belisarius530/ubalance/readme.txt

This is the first of many files,
may they all be merry and bright -JF
