belisarius530/ubalance/chassis/gsegNucleoPlatev0.pdf

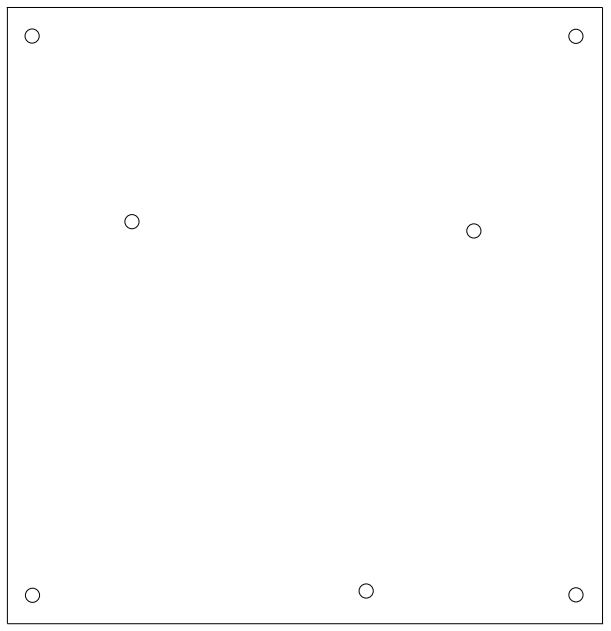
[picture p1: figure]
