belisarius530/ubalance/chassis/gsegNucleoPlatev1.pdf

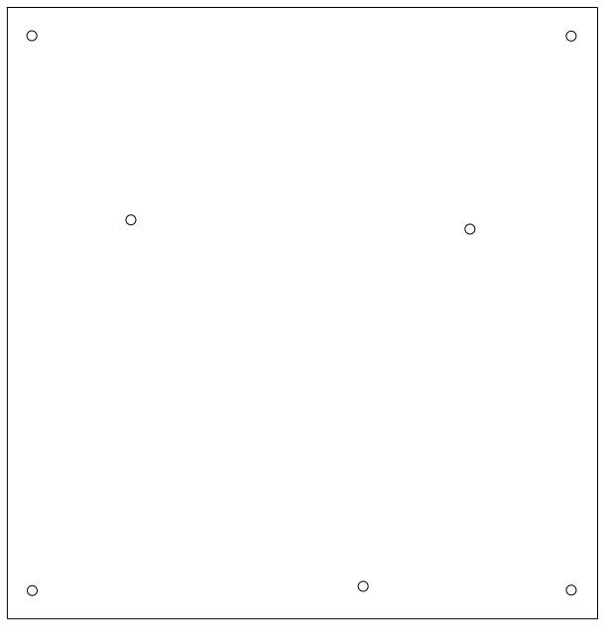
[picture p2: figure]
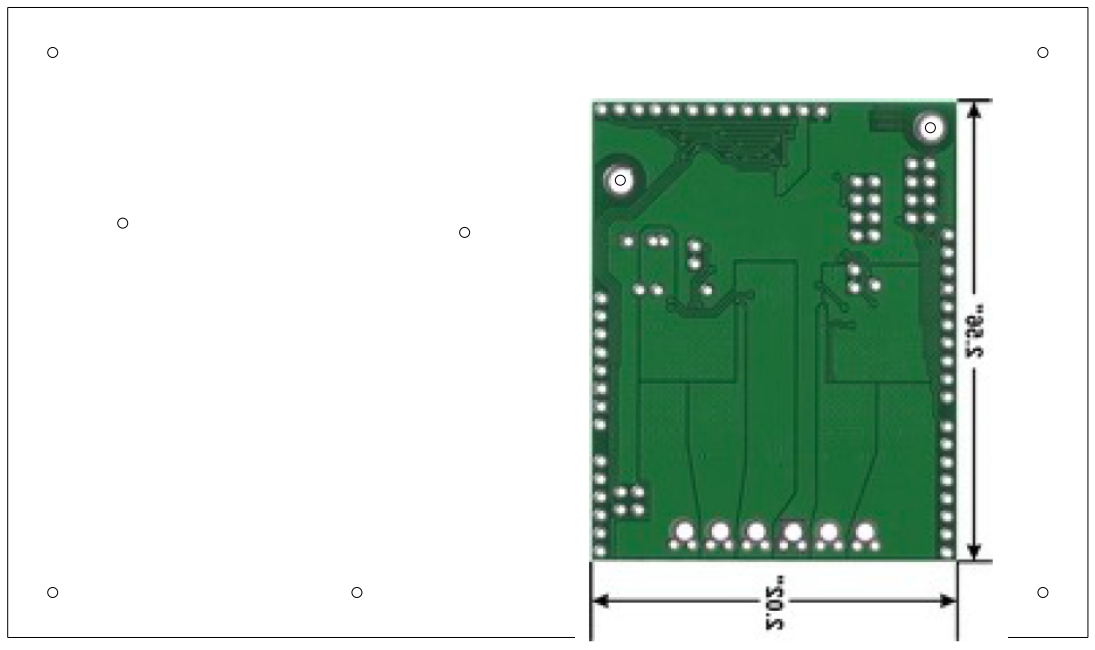
[picture p3: figure]
