belisarius530/ubalance/bom/ubalancev0.xlsx

BOM
EE521, IRL Avatar
Power Supply
Part Name | Mfc. Part Number | Specs | Footprint | Notes | Datasheet Link | Cost | Order Link | Added to digikey order
BUCK | LT3470 | 200mA, 83% efficient for 12-to-5V from 75mA up to 200mA | TSOT-23-8 | 1/b | LT3470 (http://cds.linear.com/docs/en/datasheet/3470fd.pdf) | 5.4 | Digikey (http://www.digikey.com/product-detail/en/LT3470ETS8%23TRMPBF/LT3470ETS8%23TRMPBFCT-ND/1629843) | 2
C1A, C2C, C3B | 250X15W104MV4E | .1uF, 20%, X7R , 25, Bypass/Decouple DIFFERENT FROM OTHER .1!!!! Use ON power supply and motors | 805 | 3/b | Cap (http://www.johansondielectrics.com/images/stories/surface-mount/x2y/JDI_X2Y_2013-04.pdf) | 0.55 | Digikey (http://www.digikey.com/product-detail/en/250X15W104MV4E/709-1330-1-ND/2327230) | 6
C1B, C2D | C2012X7R1E105K125AB | 1uF, 10%, 25V, MLCC, X7R | 805 | 2/b | C-series TDK Caps (http://www.tdk.com/pdf/TDKMLCCCapRange.pdf) | 0.24 | Digikey (http://www.digikey.com/product-detail/en/C2012X7R1E105K125AB/445-1354-1-ND/567595) | 4
C1C, C2B | EEE-FK1V101XP | 100uF, Aluminum, 340mOhm at 100KHz, Rated Ripple Current - 280mA | FK Series D, D8 Surface Mount Cap | 2/b | Panasonic Caps (http://industrial.panasonic.com/ww/products/capacitors/aluminum-capacitors/aluminum-cap-smd/fk-v/EEEFK1V101XP) | 0.76 | Digikey (http://www.digikey.com/product-detail/en/EEE-FK1V101XP/PCE3836CT-ND/766212) | 4
CBIASFB | C0805C220KBRACTU | 22pF, X7R, 10%, 630V(!) | 805 | 1/b | C0805C220KBRACTU Spec. (http://capacitoredge.kemet.com/capedge2/DataSheet?pn=C0805C220KBRACTU) | 0.37 | Digikey (http://www.digikey.com/product-detail/en/C0805C220KBRACTU/399-5568-1-ND/2033930) | 2
R2 | KTR10EZPF2003 | 200k, 1% | 805 | 1/b | KTR Series (http://rohmfs.rohm.com/en/products/databook/datasheet/passive/resistor/chip_resistor/ktr.pdf) | 0.17 | Digikey (http://www.digikey.com/product-detail/en/KTR10EZPF2003/RHM200KAHCT-ND/1983967) | 4
R1 | ERJ-6ENF6043V | 600k, 1% | 805 | 1/b | ERJ (http://industrial.panasonic.com/www-cgi/jvcr13pz.cgi?E+PZ+3+AOA0002+ERJ6ENF6043V+7+WW) | 0.1 | Digikey (http://www.digikey.com/product-detail/en/ERJ-6ENF6043V/P604KCCT-ND/119776) | 4
R3 | RMCF1206JT1M00 | 1M, 5% | 805 | 1/b | ERJ (http://industrial.panasonic.com/www-cgi/jvcr13pz.cgi?E+PZ+3+AOA0002+ERJ6ENF1004V+7+WW) | 0.1 | Digikey (http://www.digikey.com/product-detail/en/ERJ-6ENF1004V/P1.00MCCT-ND/119836) | 4
R4, R5 | ERJ-6GEYJ104V | 100k, 1% | 805 | 2/b | ERJ (http://industrial.panasonic.com/www-cgi/jvcr13pz.cgi?E+PZ+3+AOA0001+ERJ6GEYJ104V+7+WW) | 0.1 | Digikey (http://www.digikey.com/product-detail/en/ERJ-6GEYJ104V/P100KACT-ND/692) | 4
TBLOCK |  | 2*3.5mm |  | 2/b | 3.5mm Blocks (http://www.adafruit.com/datasheets/19963.pdf) | 2.95 | Adafruit (https://www.adafruit.com/product/724)
ZENER | MMSZ5240BT1G | 10Vz, 500mW max power, 17ohm max impedance, 900mV Vd@ 10mA | SOD-123 | 1/b | MMSz52 (http://www.onsemi.com/pub_link/Collateral/MMSZ5221BT1-D.PDF) | 0.24 | Digikey (http://www.digikey.com/product-detail/en/MMSZ5240BT1G/MMSZ5240BT1GOSCT-ND/1139896) | 4
PMOS | SUD50P06-15-GE3 | 60V Vds, Id - 50A, 15mOhm @ 17A w/ Vgs 10V, Vgs Max -+15V | T0-252-3 | 1/b | SUD50p06 (http://www.vishay.com/docs/68940/sud50p06.pdf) | 2.1 | Digikey (http://www.digikey.com/product-detail/en/SUD50P06-15-GE3/SUD50P06-15-GE3CT-ND/1979016) | 2
CBOOST | JMK105B7224KV-F | .22uF, 10%, 6.3V, x7r | 0402(FUCK!!!) | 1/b | MLCC Standard (http://www.yuden.co.jp/productdata/catalog/en/mlcc_all_e.pdf) | 0.1 | Digikey (http://www.digikey.com/product-detail/en/JMK105B7224KV-F/587-2475-1-ND/2230341) | 4
C2A | JMK316BJ226ML-T | 22uF, 20%, X5R, 6.3V | 1206 | Prescribed by LT3470 Datasheet | MLCC Standard (http://www.yuden.co.jp/productdata/catalog/en/mlcc_all_e.pdf) | 0.46 | Digikey (http://www.digikey.com/product-detail/en/JMK316BJ226ML-T/587-1347-1-ND/931124) | 2
C3A | C3216X5R1E336M160AC | 33uF, 20%, X5R, 25V | 1206 | 1/b | C series (http://product.tdk.com/en/catalog/datasheets/mlcc_commercial_general_en.pdf) | 1.28 | Digikey (http://www.digikey.com/product-detail/en/C3216X5R1E336M160AC/445-8046-1-ND/2792163) | 2
LDO | KA78RM33RTM | 3.3V, 500mA, up to 20V input, | TO-252-3 | 1/b | KA78RM33R (https://www.fairchildsemi.com/datasheets/KA/KA78RM33R.pdf) | 0.67 | Digikey (http://www.digikey.com/product-detail/en/KA78RM33RTM/KA78RM33RTMCT-ND/4213612) | 2
IND | VLCF5024T-330MR50-2 | 500mA, 33uH up through 10mHz, Shielded | Custom, see datasheet | 1/b | VLCF (http://product.tdk.com/inductor/ind/en/documents/inductor_commercial_power_vlcf_en.pdf) | 1.4 | Digikey (http://www.digikey.com/product-detail/en/VLCF5024T-330MR50-2/445-8745-1-ND/3083321) | 2
 |  |  |  |  |  |  |  | 32.24
Motor Controllers
Part Name | Mfc. Part Number | Specs | Footprint | Notes | Datasheet Link | Cost | Order Link
RENAB, RINA, RINB, RPWMA, RCSB | ERJ-6GEYJ102V | 1k, 5%, 200ppm/C, | 805 | 5*2 Per Board | ERJ (http://industrial.panasonic.com/www-cgi/jvcr13pz.cgi?E+PZ+3+AOA0001+ERJ6GEYJ102V+7+WW) | 0.1 | Digikey (http://www.digikey.com/product-detail/en/ERJ-6GEYJ102V/P1.0KACT-ND/42833) | 50
RENABPU, RPWMB, RCSA | RMCF0805JT10K0 | 10K, 1%, 100ppm/C, | 805 | 3*2/b | ERJ (http://www.seielect.com/Catalog/SEI-RMCF_RMCP.pdf) | 0.1 | Digikey (http://www.digikey.com/product-detail/en/RMCF0805JT10K0/RMCF0805JT10K0CT-ND/1942577) | 50
COUTA | PCE3805CT-ND | 470uF, 25V, 20%, 637.5mA | Panasonic G |  | EEE-FK1E471P (http://industrial.panasonic.com/www-cgi/jvcr13pz.cgi?E+PZ+3+ABA0120+EEEFK1E471P+7+WW) | 1.09 | Digikey (http://www.digikey.com/product-detail/en/EEE-FK1E471P/PCE3805CT-ND/766181) | 2
COUTA | UHW1H102MHD | 1000uF, 50V, 20% tolerance, 3.5A rated ripple current @100KHz, Through Hole | 5mm Pitch, 12.5mm Diameter | 1/b | HW Series (http://nichicon-us.com/english/products/pdfs/HW_e.pdf) | 1.66 | Digikey (http://www.digikey.com/product-detail/en/UHW1H102MHD/493-6910-ND/3664320) | 2
COUTC | EEE-FK1V101XP | 100uF, Aluminum, 340mOhm at 100KHz, Rated Ripple Current - 280mA, 35V | FK Series D, D8 Surface Mount Cap | 1*2/b | Panasonic Caps (http://industrial.panasonic.com/ww/products/capacitors/aluminum-capacitors/aluminum-cap-smd/fk-v/EEEFK1V101XP) | 0.76 | Digikey (http://www.digikey.com/product-detail/en/EEE-FK1V101XP/PCE3836CT-ND/766212) | 4
COUTB, CMO | 250X15W104MV4E | .1uF, 20%, X7R , 25, Bypass/Decouple DIFFERENT FROM OTHER .1!!!! Use ON power supply and motors | 805 | 2*2/b | Cap (http://www.johansondielectrics.com/images/stories/surface-mount/x2y/JDI_X2Y_2013-04.pdf) | 0.55 | Digikey (http://www.digikey.com/product-detail/en/250X15W104MV4E/709-1330-1-ND/2327230) | 4
CBAT, COUTD | C2012X7R1E105K125AB | 1uF, 10%, 25V, MLCC, X7R | 805 | 1*2/b | C-series TDK Caps (http://www.tdk.com/pdf/TDKMLCCCapRange.pdf) | 0.24 | Digikey (http://www.digikey.com/product-detail/en/C2012X7R1E105K125AB/445-1354-1-ND/567595) | 4
CCS | C0805C473K5RACTU | .047uF, 10%, 50V, X7R | 805 | 1*2/b | Ceramic Chip (http://www.kemet.com/docfinder?Partnumber=C0805C473K5RACTU) | 0.15 | Digikey (http://www.digikey.com/product-detail/en/C0805C473K5RACTU/399-1166-1-ND/411441) | 25
NMOS | AON6812 | 30Vdss, 27A continuous, Rds On 4mOhm @20 A | 8-VDFN | 1*2/b | AON6812 (http://aosmd.com/res/data_sheets/AON6812.pdf) | 1.08 | Digikey (http://www.digikey.com/product-detail/en/AON6812/785-1630-1-ND/4318373) | 4
DRIVER | VNH5019 | 30A, 24V | MultiPowerSO-30 | 1*2/b | VNH5019 (http://www.st.com/web/en/resource/technical/document/datasheet/CD00234623.pdf) | 8.31 | Digikey (http://www.digikey.com/product-detail/en/VNH5019ATR-E/497-13073-1-ND/3455763) | 3
IMU
Part Name | Mfc. Part Number | Specs | Footprint | Notes | Datasheet Link | Cost | Order Link
C1C | C3216C0G1H103J060AA | 10nF, 10%, 50V, X7R | 805 | 1/b | Chip Monolithic Ceramic Caps (http://search.murata.co.jp/Ceramy/image/img/A01X/partnumbering_e_01.pdf) | 0.1 | Digikey (http://www.digikey.com/product-detail/en/GRM216R71H103KA01D/490-1664-1-ND/587472) | 10
C1A, C2A | LMK212SD104KG-T | .1uF, 10%, - , 10V, RF/Microwave | 805 | 2/b | Cap (http://www.yuden.co.jp/productdata/catalog/en/mlcc07_e.pdf) | 0.36 | Digikey (http://www.digikey.com/product-detail/en/LMK212SD104KG-T/587-1134-1-ND/930911) | 10
C1B, C2B | GRM219R60J106KE19D | 10uF, 10%,6.3V, X5R, MLCC | 805 | 2/b | GRM2 (http://search.murata.co.jp/Ceramy/image/img/A01X/G101/ENG/GRM219R60J106KE19-01.pdf) | 0.15 | Digikey (http://www.digikey.com/product-detail/en/GRM219R60J106KE19D/490-3340-1-ND/702881) | 4
C2D | LMK212BJ475KD-T | 4.7uF, 5%, 10V, X7R | 805 | 1/b | Ceramic Chip (http://www.yuden.co.jp/productdata/catalog/en/mlcc_all_e.pdf) | 0.17 | Digikey (http://www.digikey.com/product-detail/en/LMK212BJ475KD-T/587-1297-1-ND/931074) | 10
C2C | JMK105B7224KV-F | .22uF, 10%, 6.3V, x7r | 0402(FUCK!!!) | 1/b | MLCC Standard (http://www.yuden.co.jp/productdata/catalog/en/mlcc_all_e.pdf) | 0.1 | Digikey (http://www.digikey.com/product-detail/en/JMK105B7224KV-F/587-2475-1-ND/2230341) | 0
L3GD20H | L3GD20HTR | Gyro | 16-LGA(3*3) | 1/b | L3GD20H (http://www.st.com/web/en/resource/technical/document/datasheet/DM00060659.pdf) | 3.61 | Digikey (http://www.digikey.com/product-detail/en/L3GD20HTR/497-13931-1-ND/4357644) | 2
LSM303DLHC | LSM303DTR | accl | 16-LGA(3*3) | 1/b | lsm303D | 3.16 | digikey (http://www.digikey.com/product-detail/en/LSM303DTR/497-13819-1-ND/4245539) | 2
Radios
Part Name | Mfc. Part Number | Specs | Footprint | Notes | Datasheet Link | Cost | Order Link
C1, C2 | LMK212SD104KG-T | .1uF, 10%, - , 10V, RF/Microwave | 805 | 2/b | Cap (http://www.yuden.co.jp/productdata/catalog/en/mlcc07_e.pdf) | 0.36 | Digikey (http://www.digikey.com/product-detail/en/LMK212SD104KG-T/587-1134-1-ND/930911) | x
C3 | LMK212BJ475KD-T | 4.7uF, 5%, 10V, X7R | 805 | 1/b | Ceramic Chip (http://www.yuden.co.jp/productdata/catalog/en/mlcc_all_e.pdf) | 0.17 | Digikey (http://www.digikey.com/product-detail/en/LMK212BJ475KD-T/587-1297-1-ND/931074) | x
Radio |  | Series 1, 1mw, wire antenna | 20 pin DIP |  | XBee/XBee-PRO RF Modules (https://www.sparkfun.com/datasheets/Wireless/Zigbee/XBee-Datasheet.pdf) | 22.95 | Adafruit (http://www.adafruit.com/products/128)
2mm Header |  | male to female, 2mm spaced headers for the Xbee | 20 pin DIP | 2/b |  | 1 | Adafruit (http://www.adafruit.com/products/366)
Microcontroller
Part Name | Mfc. Part Number | Specs | Footprint | Notes | Datasheet Link | Cost | Order Link
STM32F401 | STM32F401RCT6 | 64 pin, 84MHz, FPU | 64-LQFP | 1/b | STM32F401xB/xC (http://www.st.com/web/en/resource/technical/document/datasheet/DM00086815.pdf) | 6.56 | Digikey (http://www.digikey.com/product-search/en?FV=fff40027%2Cfff800cd%2C400460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) | 2
FB | BK1608TS601-T | 600 Ohm @ 100MHz, 350mA, DCR - 270mOhm | 603 | 1/b | BK Series (http://www.yuden.co.jp/productdata/catalog/en/mlci07_e.pdf) | 0.19 | Digikey (http://www.digikey.com/product-detail/en/BK1608TS601-T/587-1897-1-ND/1465367) | 3
C1, C2 | GQM2195C1H200JB01D | 20pF, 5%, 50V, C0G/NP0, RF/Microwave/HF, High q low loss | 805 | 2/b | Part numbering (http://search.murata.co.jp/Ceramy/image/img/A01X/partnumbering_e_01.pdf) | 0.78 | Digikey (http://www.digikey.com/product-detail/en/GQM2195C1H200JB01D/490-3607-1-ND/789607) | 4
Y1 | ECS-80-18-4XDN | 8MHz, 18pF, 100ppm, | HC49/US | 1/b | HC-49USX (http://www.ecsxtal.com/store/pdf/hc-49usx-dn.pdf) | 0.95 | Digikey (http://www.digikey.com/product-detail/en/ECS-80-18-4XDN/X1115-ND/827606) | 2
C3, C5, C6, C7, C9, C10, C12 | LMK212SD104KG-T | .1uF, 10%, - , 10V, RF/Microwave | 805 | 7/b | Cap (http://www.yuden.co.jp/productdata/catalog/en/mlcc07_e.pdf) | 0.36 | Digikey (http://www.digikey.com/product-detail/en/LMK212SD104KG-T/587-1134-1-ND/930911) | 50
C8 | LMK212BJ475KD-T | 4.7uF, 5%, 10V, X7R | 805 | 1/b | Ceramic Chip (http://www.yuden.co.jp/productdata/catalog/en/mlcc_all_e.pdf) | 0.17 | Digikey (http://www.digikey.com/product-detail/en/LMK212BJ475KD-T/587-1297-1-ND/931074) | x
C11 | 251R15S120JV4E | 12pF, 5%, 250V, C0G/NP0, HF/RF | 805 | 1/b | MLCC high q (http://www.johansontechnology.com/images/stories/catalog/JTI-CAT-MLCC-HighQ.pdf) | 0.37 | Digikey (http://www.digikey.com/product-detail/en/251R15S120JV4E/712-1378-1-ND/1833700) | 2
R1, RSDA, RSCL | RMCF0805JT10K0 | 10K, 1%, 100ppm/C, | 805 | 3/b | ERJ (http://www.seielect.com/Catalog/SEI-RMCF_RMCP.pdf) | 0.1 | Digikey (http://www.digikey.com/product-detail/en/RMCF0805JT10K0/RMCF0805JT10K0CT-ND/1942577) | 10
R2 | ERJ-6GEYJ104V | 100k, 1% | 805 | 1/b | ERJ (http://industrial.panasonic.com/www-cgi/jvcr13pz.cgi?E+PZ+3+AOA0001+ERJ6GEYJ104V+7+WW) | 0.1 | Digikey (http://www.digikey.com/product-detail/en/ERJ-6GEYJ104V/P100KACT-ND/692) | 2
R3 | ERJ-6GEYJ133V | 13k, 1%, 100ppm/C | 805 | 1/b | KTR Series (http://industrial.panasonic.com/www-cgi/jvcr13pz.cgi?E+PZ+3+AOA0001+ERJ6GEYJ133V+7+WW) | 0.2 | Digikey (http://www.digikey.com/product-detail/en/ERJ-6GEYJ133V/P13KACT-ND/19868) | 2
C4 | C2012X7R1E105K125AB | 1uF, 10%, 25V, MLCC, X7R | 805 | 1/b | C-series TDK Caps (http://www.tdk.com/pdf/TDKMLCCCapRange.pdf) | 0.24 | Digikey (http://www.digikey.com/product-detail/en/C2012X7R1E105K125AB/445-1354-1-ND/567595)
IMU_C1B | UMK316BBJ106ML-T | 10uF, 20%, 50V, X5R, MLCC | 1206 |  | TaiyoYuden MLCC (http://www.yuden.co.jp/productdata/catalog/en/mlcc_all_e.pdf) | 0.64 | Digikey (http://www.digikey.com/product-detail/en/UMK316BBJ106ML-T/587-3248-1-ND/3660103)
PS_C1E | UHW1H102MHD | 1000uF, 50V, 20% tolerance, 3.5A rated ripple current @100KHz, Through Hole | 5mm Pitch, 12.5mm Diameter | 1 at power supply input | HW Series (http://nichicon-us.com/english/products/pdfs/HW_e.pdf) | 1.66 | Digikey (http://www.digikey.com/product-detail/en/UHW1H102MHD/493-6910-ND/3664320)
