belisarius530/ubalance/pcb/ubalancev0.brd

## EAGLE design pcb/ubalancev0.brd (2015-09-03)

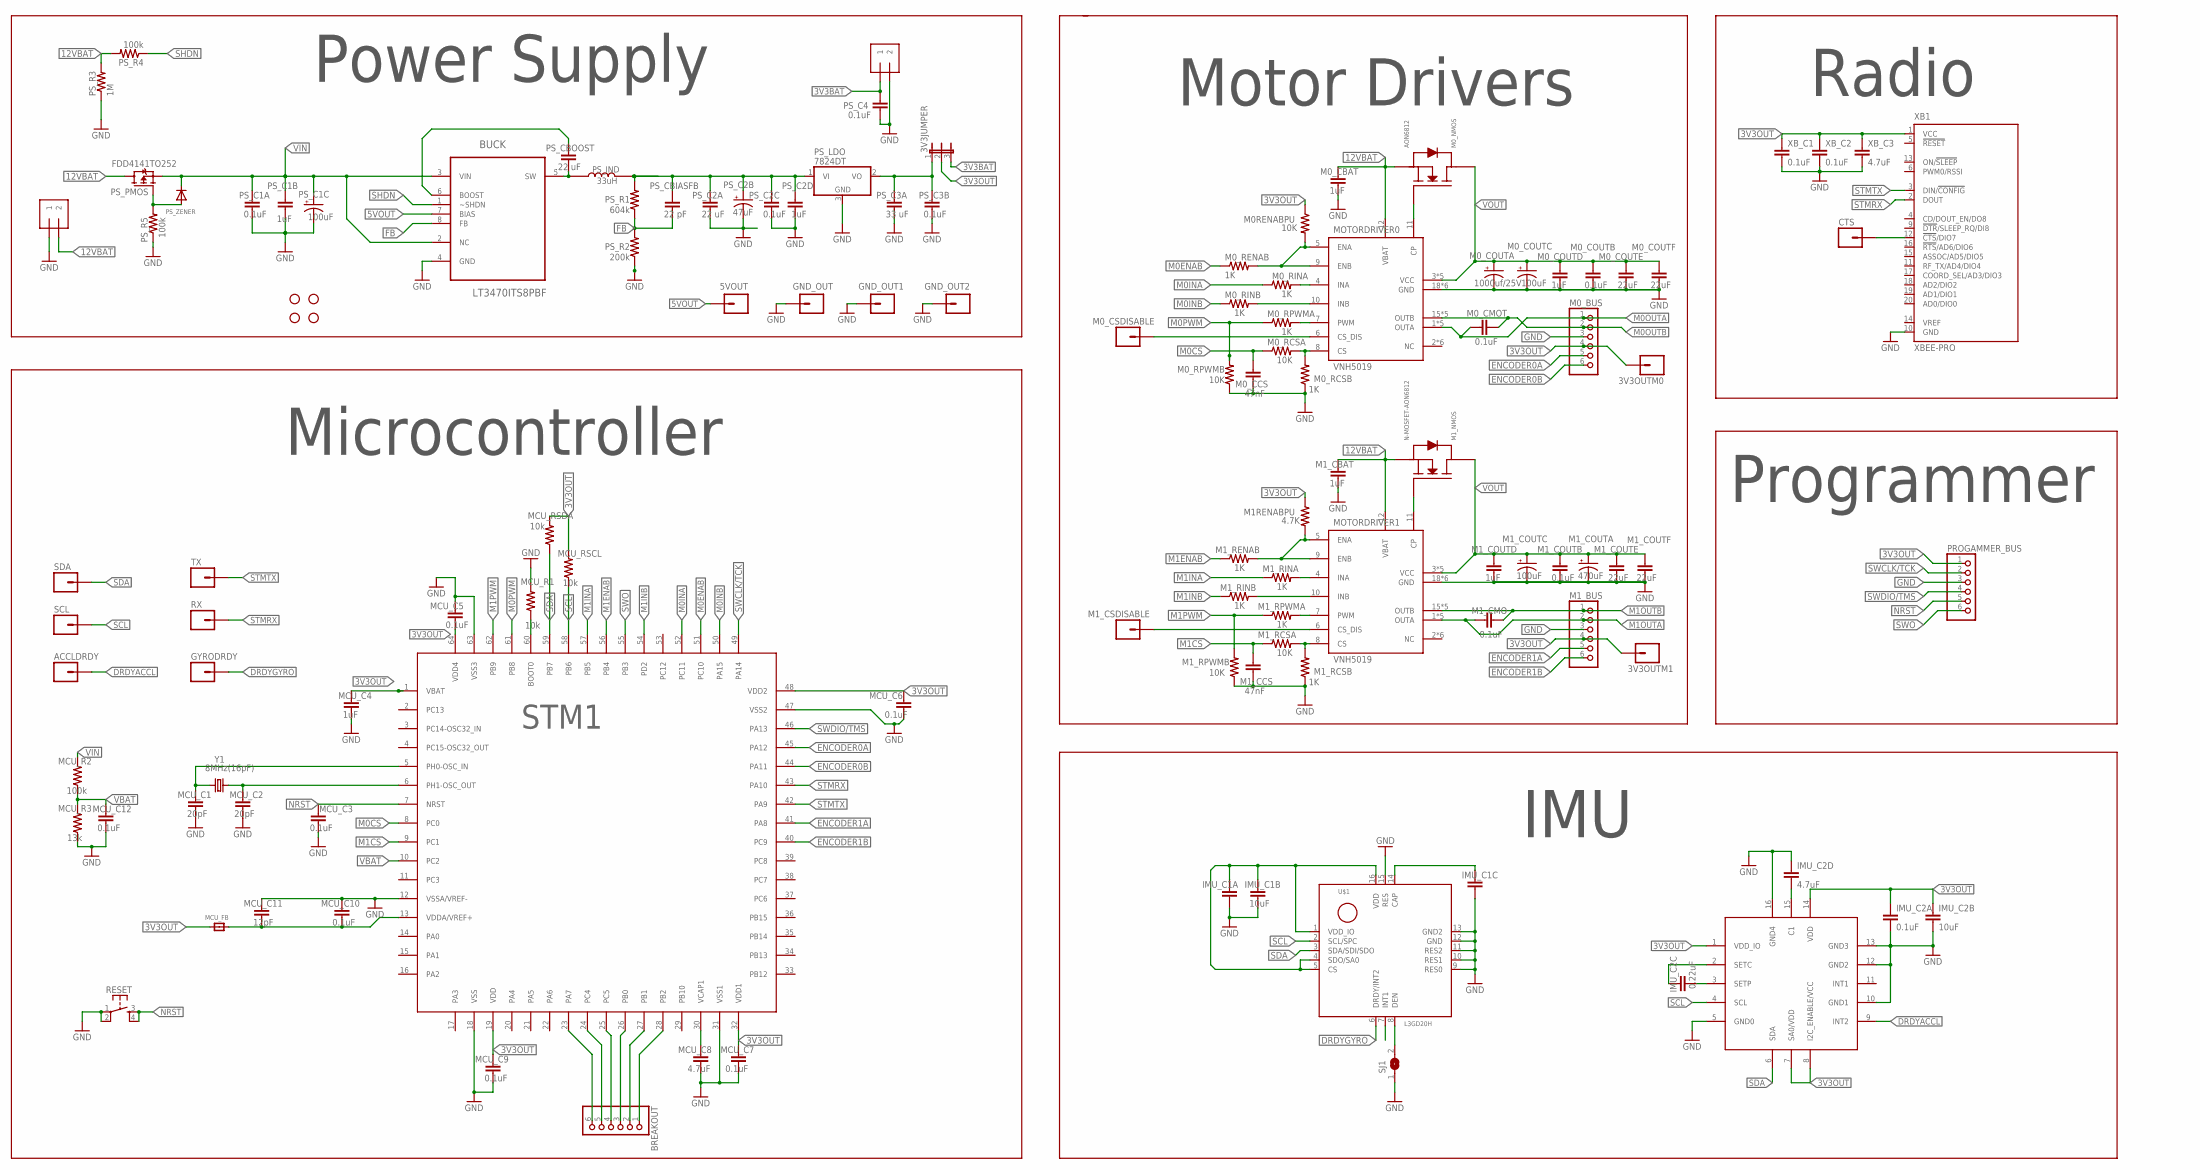
[picture p4: schematic ubalancev0.sch]

Parts:
3V3JUMPER: JUMPER3
3V3OUTM0, 3V3OUTM1, 5VOUT: M01PTH; 1X01
ACCLDRDY: M01PTH; 1X01
BREAKOUT: PINHD-1X6LOCK; 1X06-BIGLOCK
BUCK: LT3470ITS8PBF; SOT65P280X100-8N
CTS: M01PTH; 1X01
GND_OUT, GND_OUT1, GND_OUT2: M01PTH; 1X01
GYRODRDY: M01PTH; 1X01
IMU_C1A, IMU_C2A: 0.1uF; 0805
IMU_C1B, IMU_C2B: 10uF; 0805
IMU_C1C: 10nF; 0805
IMU_C2C: 0.22uF; 0805
IMU_C2D: 4.7uF; 0805
M0RENABPU, M0_RCSA, M0_RPWMB, M1_RCSA, M1_RPWMB: 10K; 0805
M0_BUS, M1_BUS: PINHD-1X6LOCK; 1X06-BIGLOCK
M0_CBAT, M0_COUTD, M1_CBAT, M1_COUTD: 1uF; 0805
M0_CCS, M1_CCS: 47nF; 0805
M0_CMOT, M0_COUTB, M1_CMO, M1_COUTB: 0.1uF; 0805
M0_COUTA: 1000uf/25V; CPOL-RADIAL-1000UF-25V-KIT
M0_COUTC, M1_COUTC: 100uF; PANASONIC_D
M0_COUTE, M1_COUTE, M1_COUTF: 22uF; 1206
M0_COUTF: 22uF; 0805
M0_CSDISABLE, M1_CSDISABLE: M01PTH; 1X01
M0_NMOS: AON6812; 8DFN-5*6MM
M0_RCSB, M0_RENAB, M0_RINA, M0_RINB, M0_RPWMA, M1_RCSB, M1_RENAB, M1_RINA, M1_RINB, M1_RPWMA: 1K; 0805
M1RENABPU: 4.7K; 0805
M1_COUTA: 470uF; PANASONIC_G
M1_NMOS: N-MOSFET-AON6812; 8DFN-5*6MM
MCU_C1, MCU_C2: 20pF; 0805
MCU_C3, MCU_C5, MCU_C6, MCU_C7, MCU_C9, MCU_C10, MCU_C12: 0.1uF; 0805
MCU_C4: 1uF; 0805
MCU_C8: 4.7uF; 0805
MCU_C11: 12pF; 0805
MCU_FB: FERRITE; 0603
MCU_R1: 10k; 0805
MCU_R2: 100k; 0805
MCU_R3: 13k; 0805
MCU_RSCL: 10k; 0805
MCU_RSDA: 10k; 0805
MOTORDRIVER0, MOTORDRIVER1: VNH5019; MULTIPOWERSO-30
PROGAMMER_BUS: PINHD-1X6LOCK; 1X06-BIGLOCK
PS_3V3TERM, PS_12VTERM: 1X2-3.5MM
PS_C1A, PS_C2C, PS_C3B, PS_C4: 0.1uF; 0805
PS_C1B, PS_C2D: 1uF; 0805
PS_C1C: 100uF; PANASONIC_D
PS_C2A: 22 uF; 1206
PS_C2B: 47uF; PANASONIC_D
PS_C3A: 33 uF; 1206
PS_CBIASFB: 22 pF; 0805
PS_CBOOST: .22 uF; 0402-CAP
PS_IND: 33uH; VLCF5024
PS_LDO: 7824DT; TO252
PS_PMOS: FDD4141TO252; TO252
PS_R1: 604k; 0805
PS_R2: 200k; 0805
PS_R3: 1M; 0805
PS_R4, PS_R5: 100k; 0805
PS_ZENER: DIODESOD-123; SOD-123
RESET: TAC_SWITCHPTH; TACTILE-PTH
RX: M01PTH; 1X01
SCL: M01PTH; 1X01
SDA: M01PTH; 1X01
SJ1: SOLDERJUMPER; SOLDERJUMPER_ARROW_NOPASTE
STANDOFF1, STANDOFF2, STANDOFF3, STANDOFF4: STAND-OFF
STM1: STM32F4; LQFP64
TX: M01PTH; 1X01
U$1: L3GD20H; LGA16_3X3MM
U$2: LSM303D; LGA16_3X3MM
XB1: XBEE-PRO
XB_C1, XB_C2: 0.1uF; 0805
XB_C3: 4.7uF; 0805
Y1: 8MHz(16pF); HC49US

Connections:
3V3BAT: 3V3JUMPER.3, PS_3V3TERM.1, PS_C4.1
3V3OUT: 3V3JUMPER.2, 3V3OUTM0.1, 3V3OUTM1.1, IMU_C1A.1, IMU_C1B.1, IMU_C2A.1, IMU_C2B.1, M0RENABPU.1, M0_BUS.4, M1RENABPU.1, M1_BUS.4, MCU_C4.1, MCU_C5.1, MCU_C6.2, MCU_C7.1, MCU_C9.1, MCU_FB.1, MCU_RSCL.2, MCU_RSDA.2, PROGAMMER_BUS.1, STM1.1 (VBAT), STM1.19 (VDD), STM1.32 (VDD1), STM1.48 (VDD2), STM1.64 (VDD4), U$1.1 (VDD_IO), U$1.4 (SDO/SA0), U$1.5 (CS), U$1.16 (VDD), U$2.1 (VDD_IO), U$2.7 (SA0/VDD), U$2.8 (I2C_ENABLE/VCC), U$2.14 (VDD), XB1.1 (VCC), XB_C1.1, XB_C2.1, XB_C3.1
3V3OUTREG: 3V3JUMPER.1, PS_C3A.1, PS_C3B.1, PS_LDO.2 (VO)
5VOUT: 5VOUT.1, BUCK.7 (BIAS), PS_C2A.1, PS_C2B.+, PS_C2C.1, PS_C2D.1, PS_CBIASFB.1, PS_IND.P2, PS_LDO.1 (VI), PS_R1.2
12VBAT: M0_CBAT.1, M0_NMOS.S1 (SOURCE), M0_NMOS.S2 (SOURCE), M0_NMOS.S3 (SOURCE), M1_CBAT.1, M1_NMOS.S1 (SOURCE), M1_NMOS.S2 (SOURCE), M1_NMOS.S3 (SOURCE), MOTORDRIVER0.12 (VBAT), MOTORDRIVER1.12 (VBAT), PS_12VTERM.2, PS_PMOS.3 (D), PS_R3.2, PS_R4.2
CAP: IMU_C1C.1, U$1.14 (CAP)
DRDYACCL: ACCLDRDY.1, U$2.9 (INT2)
DRDYGYRO: GYRODRDY.1, U$1.6 (DRDY/INT2)
ENCODER0A: M0_BUS.5, STM1.45 (PA12)
ENCODER0B: M0_BUS.6, STM1.44 (PA11)
ENCODER1A: M1_BUS.5, STM1.41 (PA8)
ENCODER1B: M1_BUS.6, STM1.40 (PC9)
FB: BUCK.8 (FB), PS_CBIASFB.2, PS_R1.1, PS_R2.2
GND: BUCK.4 (GND), GND_OUT.1, GND_OUT1.1, GND_OUT2.1, IMU_C1A.2, IMU_C1B.2, IMU_C1C.2, IMU_C2A.2, IMU_C2B.2, IMU_C2D.1, M0_BUS.3, M0_CBAT.2, M0_CCS.2, M0_COUTA.-, M0_COUTB.2, M0_COUTC.-, M0_COUTD.2, M0_COUTE.2, M0_COUTF.2, M0_RCSB.1, M0_RPWMB.1, M1_BUS.3, M1_CBAT.2, M1_CCS.2, M1_COUTA.-, M1_COUTB.2, M1_COUTC.-, M1_COUTD.2, M1_COUTE.2, M1_COUTF.2, M1_RCSB.1, M1_RPWMB.1, MCU_C1.2, MCU_C2.2, MCU_C3.2, MCU_C4.2, MCU_C5.2, MCU_C6.1, MCU_C7.2, MCU_C8.2, MCU_C9.2, MCU_C10.2, MCU_C11.1, MCU_C12.2, MCU_R1.2, MCU_R3.1, MOTORDRIVER0.18 (GND), MOTORDRIVER0.19 (GND), MOTORDRIVER0.20 (GND), MOTORDRIVER0.26 (GND), MOTORDRIVER0.27 (GND), MOTORDRIVER0.28 (GND), MOTORDRIVER1.18 (GND), MOTORDRIVER1.19 (GND), MOTORDRIVER1.20 (GND), MOTORDRIVER1.26 (GND), MOTORDRIVER1.27 (GND), MOTORDRIVER1.28 (GND), PROGAMMER_BUS.3, PS_3V3TERM.2, PS_12VTERM.1, PS_C1A.2, PS_C1B.2, PS_C1C.-, PS_C2A.2, PS_C2B.-, PS_C2C.2, PS_C2D.2, PS_C3A.2, PS_C3B.2, PS_C4.2, PS_LDO.3 (GND), PS_R2.1, PS_R3.1, PS_R5.1, RESET.1, RESET.2, SJ1.1, STM1.12 (VSSA/VREF-), STM1.18 (VSS), STM1.31 (VSS1), STM1.47 (VSS2), STM1.63 (VSS3), U$1.9 (RES0), U$1.10 (RES1), U$1.11 (RES2), U$1.12 (GND), U$1.13 (GND2), U$1.15 (RES), U$2.5 (GND0), U$2.10 (GND1), U$2.12 (GND2), U$2.13 (GND3), U$2.16 (GND4), XB1.10 (GND), XB_C1.2, XB_C2.2, XB_C3.2
M0CS: M0_CCS.1, M0_RCSA.1, STM1.8 (PC0)
M0ENAB: M0_RENAB.1, STM1.51 (PC10)
M0INA: M0_RINA.1, STM1.52 (PC11)
M0INB: M0_RINB.1, STM1.50 (PA15)
M0OUTA: M0_BUS.1, M0_CMOT.1, MOTORDRIVER0.1 (OUTA), MOTORDRIVER0.25 (OUTA), MOTORDRIVER0.30 (OUTA), MOTORDRIVER0.OUTA, MOTORDRIVER0.OUTA@1 (OUTA)
M0OUTB: M0_BUS.2, M0_CMOT.2, MOTORDRIVER0.15 (OUTB), MOTORDRIVER0.16 (OUTB), MOTORDRIVER0.21 (OUTB), MOTORDRIVER0.OUTB, MOTORDRIVER0.OUTB@1 (OUTB)
M0PWM: M0_RPWMA.1, M0_RPWMB.2, STM1.61 (PB8)
M1CS: M1_CCS.1, M1_RCSA.1, STM1.9 (PC1)
M1ENAB: M1_RENAB.1, STM1.56 (PB4)
M1INA: M1_RINA.1, STM1.57 (PB5)
M1INB: M1_RINB.1, STM1.54 (PD2)
M1OUTA: M1_BUS.2, M1_CMO.1, MOTORDRIVER1.1 (OUTA), MOTORDRIVER1.25 (OUTA), MOTORDRIVER1.30 (OUTA), MOTORDRIVER1.OUTA, MOTORDRIVER1.OUTA@1 (OUTA)
M1OUTB: M1_BUS.1, M1_CMO.2, MOTORDRIVER1.15 (OUTB), MOTORDRIVER1.16 (OUTB), MOTORDRIVER1.21 (OUTB), MOTORDRIVER1.OUTB, MOTORDRIVER1.OUTB@1 (OUTB)
M1PWM: M1_RPWMA.1, M1_RPWMB.2, STM1.62 (PB9)
unnamed: M1_NMOS.G (GATE), MOTORDRIVER1.11 (CP)
unnamed: BUCK.6 (BOOST), PS_CBOOST.1
unnamed: M0_NMOS.G (GATE), MOTORDRIVER0.11 (CP)
unnamed: IMU_C2C.1, U$2.3 (SETP)
unnamed: BREAKOUT.6, STM1.23 (PA7)
unnamed: M0RENABPU.2, M0_RENAB.2, MOTORDRIVER0.5 (ENA), MOTORDRIVER0.9 (ENB)
unnamed: MCU_C10.1, MCU_C11.2, MCU_FB.2, STM1.13 (VDDA/VREF+)
unnamed: BREAKOUT.5, STM1.24 (PC4)
unnamed: M0_RINA.2, MOTORDRIVER0.4 (INA)
unnamed: M0_RINB.2, MOTORDRIVER0.10 (INB)
unnamed: M0_RPWMA.2, MOTORDRIVER0.7 (PWM)
unnamed: M0_CSDISABLE.1, MOTORDRIVER0.6 (CS_DIS)
unnamed: M0_RCSA.2, M0_RCSB.2, MOTORDRIVER0.8 (CS)
unnamed: MCU_C8.1, STM1.30 (VCAP1)
unnamed: MCU_R1.1, STM1.60 (BOOT0)
unnamed: IMU_C2D.2, U$2.15 (C1)
unnamed: IMU_C2C.2, U$2.2 (SETC)
unnamed: BREAKOUT.4, STM1.25 (PC5)
unnamed: M1RENABPU.2, M1_RENAB.2, MOTORDRIVER1.5 (ENA), MOTORDRIVER1.9 (ENB)
unnamed: M1_RINA.2, MOTORDRIVER1.4 (INA)
unnamed: M1_RINB.2, MOTORDRIVER1.10 (INB)
unnamed: M1_RPWMA.2, MOTORDRIVER1.7 (PWM)
unnamed: M1_CSDISABLE.1, MOTORDRIVER1.6 (CS_DIS)
unnamed: M1_RCSA.2, M1_RCSB.2, MOTORDRIVER1.8 (CS)
unnamed: BREAKOUT.3, STM1.26 (PB0)
unnamed: MCU_C1.1, STM1.5 (PH0-OSC_IN), Y1.1
unnamed: MCU_C2.1, STM1.6 (PH1-OSC_OUT), Y1.2
unnamed: BREAKOUT.2, STM1.27 (PB1)
unnamed: BREAKOUT.1, STM1.28 (PB2)
unnamed: SJ1.2, U$1.8 (DEN)
unnamed: CTS.1, XB1.12 (!CTS!/DIO7)
NRST: MCU_C3.1, PROGAMMER_BUS.5, RESET.3, RESET.4, STM1.7 (NRST)
PMOSGATE: PS_PMOS.1 (G), PS_R5.2, PS_ZENER.A
SCL: MCU_RSCL.1, SCL.1, STM1.58 (PB6), U$1.2 (SCL/SPC), U$2.4 (SCL)
SDA: MCU_RSDA.1, SDA.1, STM1.59 (PB7), U$1.3 (SDA/SDI/SDO), U$2.6 (SDA)
SHDN: BUCK.1 (~SHDN), PS_R4.1
STMRX: RX.1, STM1.43 (PA10), XB1.2 (DOUT)
STMTX: STM1.42 (PA9), TX.1, XB1.3 (DIN/!CONFIG)
SW: BUCK.5 (SW), PS_CBOOST.2, PS_IND.P1
SWCLK/TCK: PROGAMMER_BUS.2, STM1.49 (PA14)
SWDIO/TMS: PROGAMMER_BUS.4, STM1.46 (PA13)
SWO: PROGAMMER_BUS.6, STM1.55 (PB3)
VBAT: MCU_C12.1, MCU_R2.1, MCU_R3.2, STM1.10 (PC2)
VIN: BUCK.2 (NC), BUCK.3 (VIN), MCU_R2.2, PS_C1A.1, PS_C1B.1, PS_C1C.+, PS_PMOS.2 (S), PS_ZENER.C
VOUT: M0_COUTA.+, M0_COUTB.1, M0_COUTC.+, M0_COUTD.1, M0_COUTE.1, M0_COUTF.1, M0_NMOS.D1 (DRAIN), M0_NMOS.D2 (DRAIN), M0_NMOS.D3 (DRAIN), M0_NMOS.D4 (DRAIN), M0_NMOS.D5 (DRAIN), M1_COUTA.+, M1_COUTB.1, M1_COUTC.+, M1_COUTD.1, M1_COUTE.1, M1_COUTF.1, M1_NMOS.D1 (DRAIN), M1_NMOS.D2 (DRAIN), M1_NMOS.D3 (DRAIN), M1_NMOS.D4 (DRAIN), M1_NMOS.D5 (DRAIN), MOTORDRIVER0.3 (VCC), MOTORDRIVER0.13 (VCC), MOTORDRIVER0.23 (VCC), MOTORDRIVER0.VCC, MOTORDRIVER0.VCC@1 (VCC), MOTORDRIVER1.3 (VCC), MOTORDRIVER1.13 (VCC), MOTORDRIVER1.23 (VCC), MOTORDRIVER1.VCC, MOTORDRIVER1.VCC@1 (VCC)

Notes on the sheet:
Microcontroller
Power Supply
Motor Drivers
Radio
IMU
Programmer

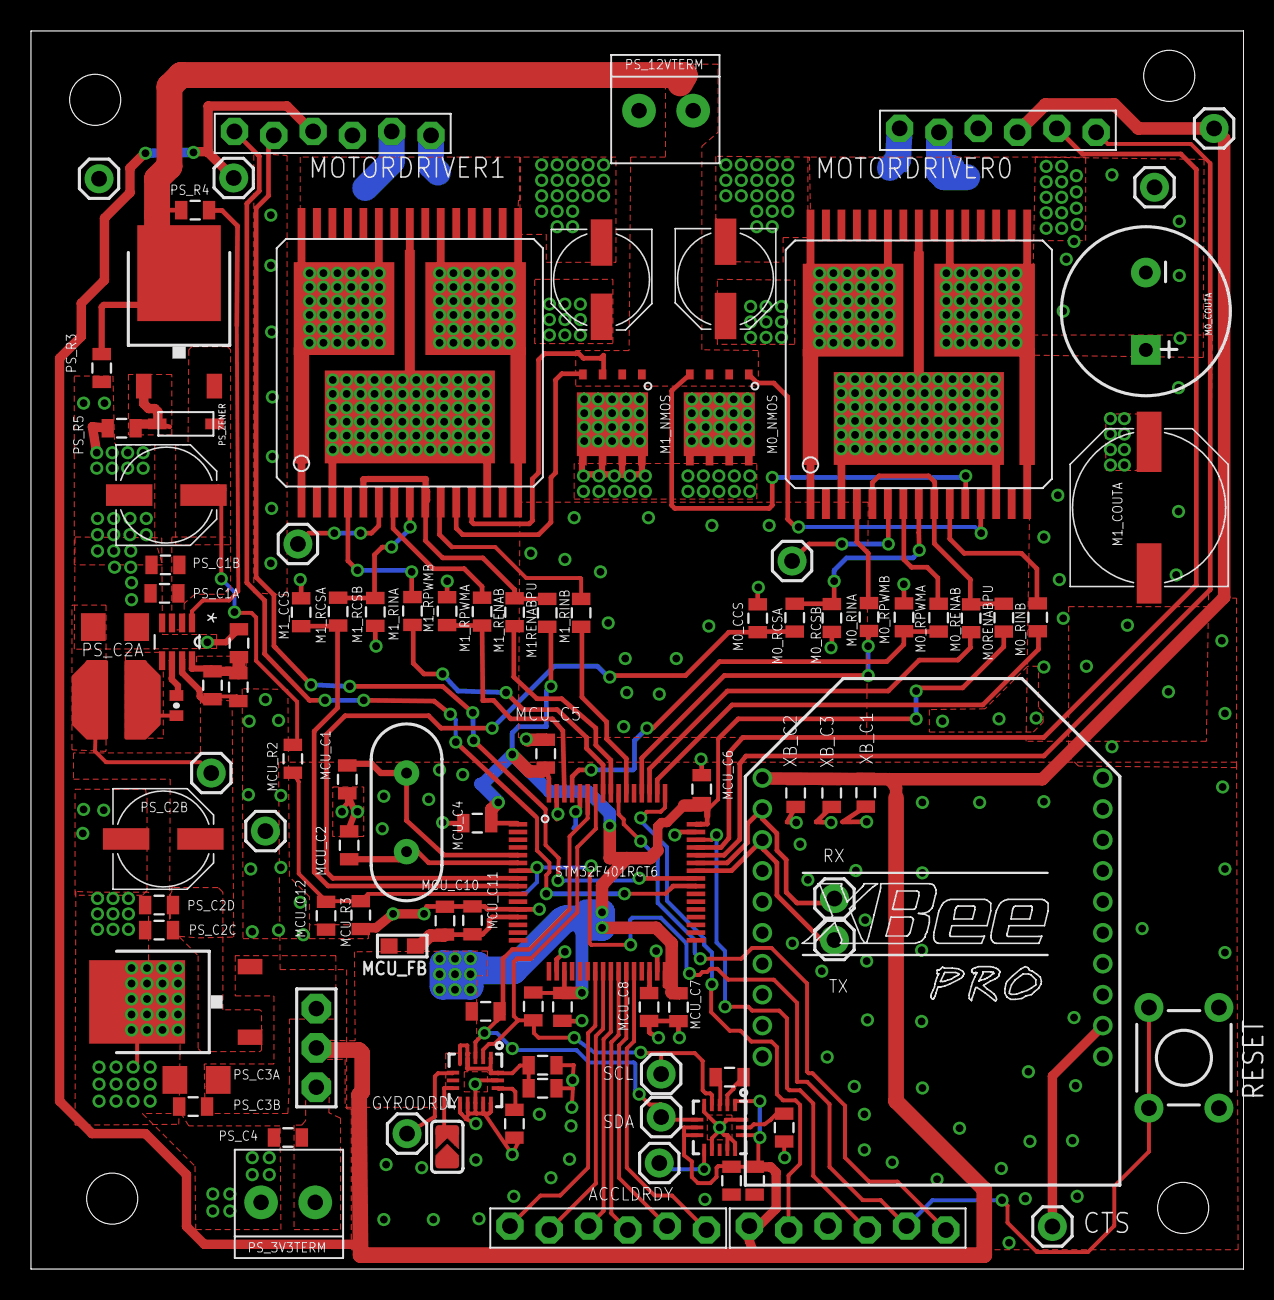
[picture p5: board ubalancev0.brd from above]

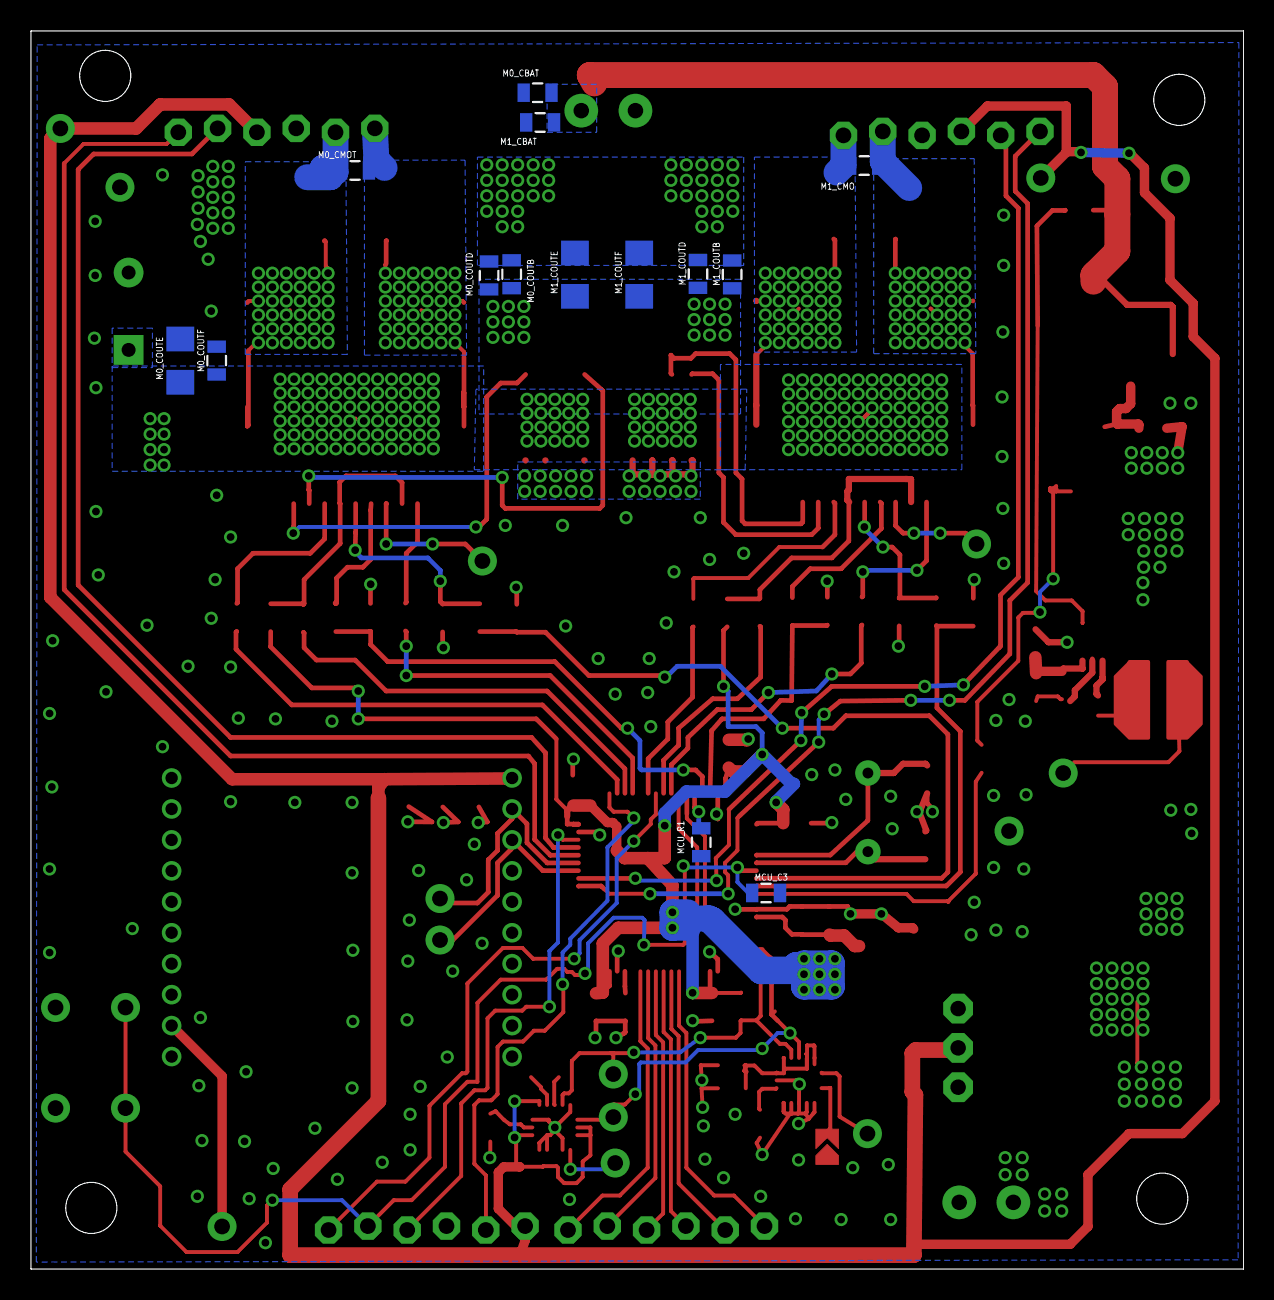
[picture p6: board ubalancev0.brd from below]

Board: 2 copper layers, 78.3 x 80.0 mm, 121 parts (14 on the bottom side), 73 nets.
