belisarius530/ubalance/(commit log)

2015-09-03 First serious commit
    [ubalancev0.brd, ubalancev0.sch, ubalancev0.xlsx]
2015-09-03 added laser chasis design files
